DAmesberger/raspicomm/RaspiComm_v3.brd

## EAGLE design RaspiComm_v3.brd (2018-06-05, an earlier design)

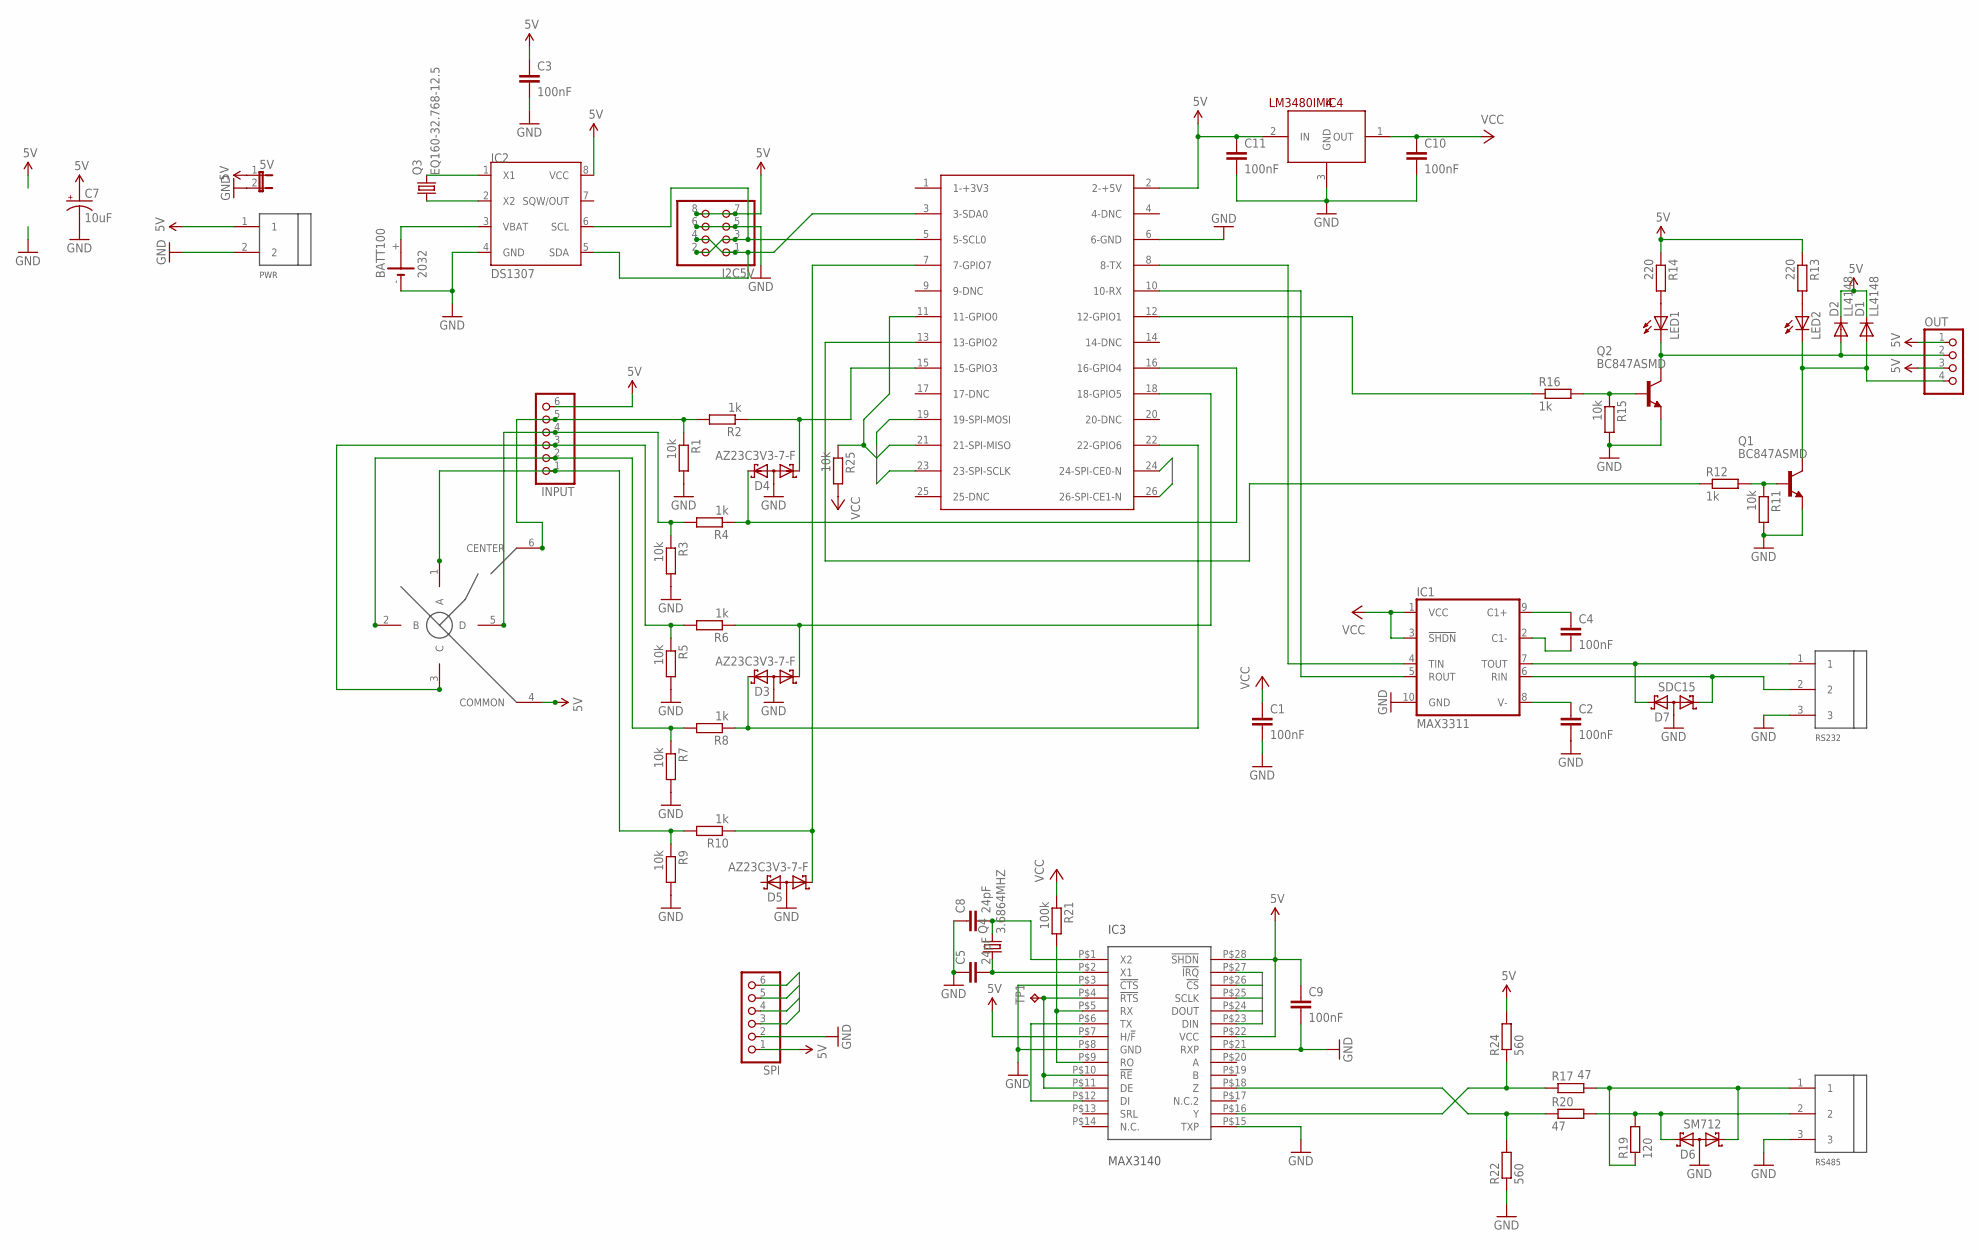
[picture p1: schematic RaspiComm_v3.sch]

Parts:
5V: JP1E; JP1
BATT100: 2032; KZH20SMD
C1, C2, C3, C4, C9, C10, C11: 100nF; C0603
C5, C8: 24pF; C0603
C7: 10uF; B(3528-21)
D1, D2: LL4148; SOD80C
D3, D4, D5: AZ23C3V3-7-F; SOT23
D6: SM712; SOT23
D7: SDC15; SOT23
I2C5V: PINHD-2X4_2.54-SMD; 2X04SMD
IC1: MAX3311; UMAX10
IC2: DS1307; SOIC-8
IC3: MAX3140; QSOP28
IC4: LM3480IM4; SOT23-3
INPUT: PINHD-1X6_2.00; 1X06M
LED1, LED2: LEDSML0805; SML0805
OUT: PINHD-1X4_2.00; 1X04M
PWR: 31182102
Q1, Q2: BC847ASMD; SOT23
Q3: EQ160-32.768-12.5; EQ160
Q4: 3.6864MHZ; 49USMX
R1, R3, R5, R7, R9, R11, R15, R25: 10k; R0603
R2, R4, R6, R8, R10, R12, R16: 1k; R0603
R13, R14: 220; R0603
R17, R20: 47; R1206
R19: 120; R1206
R21: 100k; R0603
R22, R24: 560; R0603
RS232, RS485: 31182103
SPI: PINHD-1X6_2.00; 1X06M
SW1: SKQUDBE010; SKQU-SMD
TP1: TPB1,27; B1,27
U$7: RASPBERRY-PIHEADER; RASPI_GPIO_HEADER

Connections:
5V: 5V.1, C3.1, C7.+, C9.1, C11.1, D1.C, D2.C, I2C5V.7, I2C5V.8, IC2.8 (VCC), IC3.P$7 (H/!F), IC3.P$22 (VCC), IC3.P$28 (!SHDN), IC4.2 (IN), INPUT.6, OUT.1, OUT.3, PWR.1, R13.1, R14.1, R24.2, SPI.1, SW1.4 (COMMON), U$7.2 (2-+5V)
CS1: IC3.P$26 (!CS), U$7.24 (24-SPI-CE0-N)
CS2: SPI.3, U$7.26 (26-SPI-CE1-N)
GND: 5V.2, BATT100.-, C1.2, C2.2, C3.2, C5.1, C7.-, C8.1, C9.2, C10.2, C11.2, D3.3 (AA), D4.3 (AA), D5.3 (AA), D6.3 (AA), D7.3 (AA), I2C5V.5, I2C5V.6, IC1.10 (GND), IC2.4 (GND), IC3.P$3 (!CTS), IC3.P$8 (GND), IC3.P$15 (TXP), IC3.P$21 (RXP), IC4.3 (GND), PWR.2, Q1.2 (E), Q2.2 (E), R1.2, R3.2, R5.2, R7.2, R9.2, R11.2, R15.2, R22.1, RS232.3, RS485.3, SPI.2, U$7.6 (6-GND)
IRQ: IC3.P$27 (!IRQ), R25.1, U$7.11 (11-GPIO0)
MISO: IC3.P$24 (DOUT), SPI.5, U$7.21 (21-SPI-MISO)
MOSI: IC3.P$23 (DIN), SPI.6, U$7.19 (19-SPI-MOSI)
unnamed: R16.1, U$7.12 (12-GPIO1)
unnamed: C5.2, IC3.P$2 (X1), Q4.P$1 (1)
unnamed: IC3.P$5 (RX), IC3.P$9 (RO), R21.2
unnamed: IC2.1 (X1), Q3.P$2 (2)
unnamed: IC3.P$16 (Y), R17.1, R24.1
unnamed: IC3.P$18 (Z), R20.1, R22.2
unnamed: I2C5V.2, I2C5V.3, IC2.6 (SCL), U$7.5 (5-SCL0)
unnamed: INPUT.5, R1.1, R2.2, SW1.6 (CENTER)
unnamed: IC3.P$4 (!RTS), IC3.P$10 (!RE), IC3.P$11 (DE), TP1.TP
unnamed: INPUT.4, R3.1, R4.2, SW1.5 (D)
unnamed: INPUT.3, R5.1, R6.2, SW1.3 (C)
unnamed: INPUT.2, R7.1, R8.2, SW1.2 (B)
unnamed: INPUT.1, R9.1, R10.2, SW1.1 (A)
unnamed: D4.1 (K1), R2.1, U$7.15 (15-GPIO3)
unnamed: D4.2 (K2), R4.1, U$7.16 (16-GPIO4)
unnamed: D3.1 (K1), R6.1, U$7.18 (18-GPIO5)
unnamed: D3.2 (K2), R8.1, U$7.22 (22-GPIO6)
unnamed: D5.1 (K1), R10.1, U$7.7 (7-GPIO7)
unnamed: D6.2 (K2), R19.2, R20.2, RS485.2
unnamed: C2.1, IC1.8 (V-)
unnamed: C4.2, IC1.2 (C1-)
unnamed: C4.1, IC1.9 (C1+)
unnamed: D6.1 (K1), R17.2, R19.1, RS485.1
unnamed: LED1.A, R14.2
unnamed: D7.2 (K2), IC1.7 (TOUT), RS232.1
unnamed: D7.1 (K1), IC1.6 (RIN), RS232.2
unnamed: C8.2, IC3.P$1 (X2), Q4.P$2 (2)
unnamed: LED2.A, R13.2
unnamed: D1.A, LED2.C, OUT.4, Q1.3 (C)
unnamed: I2C5V.1, I2C5V.4, IC2.5 (SDA), U$7.3 (3-SDA0)
unnamed: D2.A, LED1.C, OUT.2, Q2.3 (C)
unnamed: IC2.2 (X2), Q3.P$1 (1)
unnamed: Q2.1 (B), R15.1, R16.2
unnamed: Q1.1 (B), R11.1, R12.2
unnamed: BATT100.+, IC2.3 (VBAT)
unnamed: IC3.P$6 (TX), IC3.P$12 (DI)
unnamed: R12.1, U$7.13 (13-GPIO2)
RX: IC1.5 (ROUT), U$7.10 (10-RX)
SCLK: IC3.P$25 (SCLK), SPI.4, U$7.23 (23-SPI-SCLK)
TX: IC1.4 (TIN), U$7.8 (8-TX)
VCC: C1.1, C10.1, IC1.1 (VCC), IC1.3 (!SHDN), IC4.1 (OUT), R21.1, R25.2

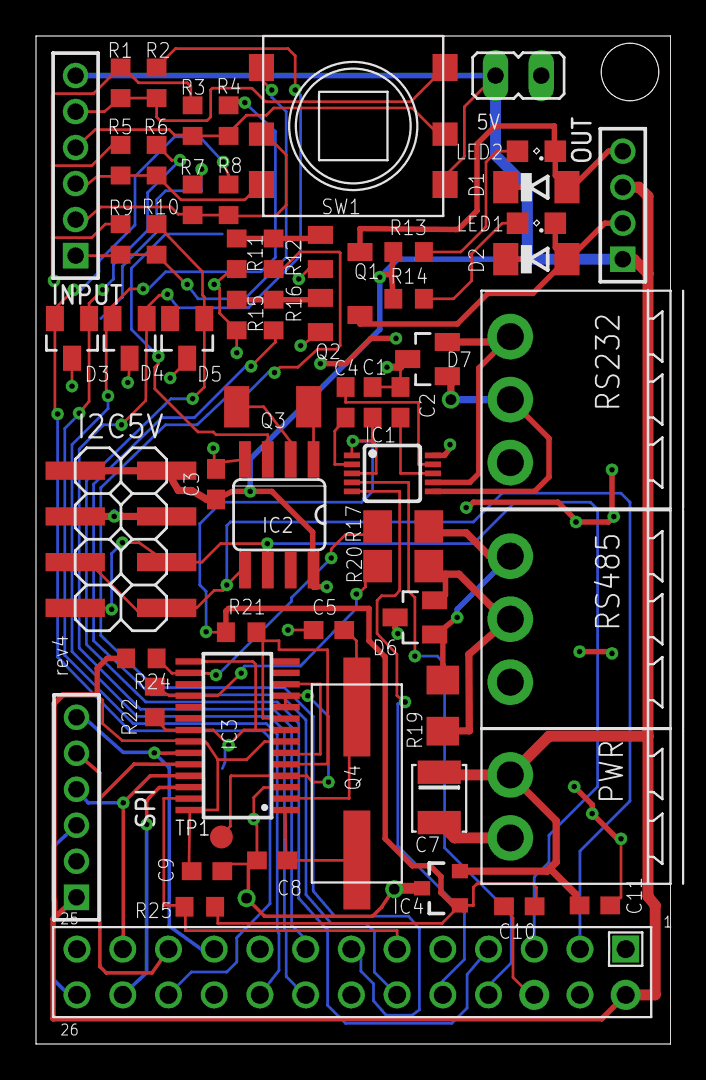
[picture p2: board RaspiComm_v3.brd from above]

Board: 2 copper layers, 35.2 x 56.0 mm, 62 parts (1 on the bottom side), 48 nets.
